u2sb/ObsKeyBoard-SB00/成品/装配2.jpg

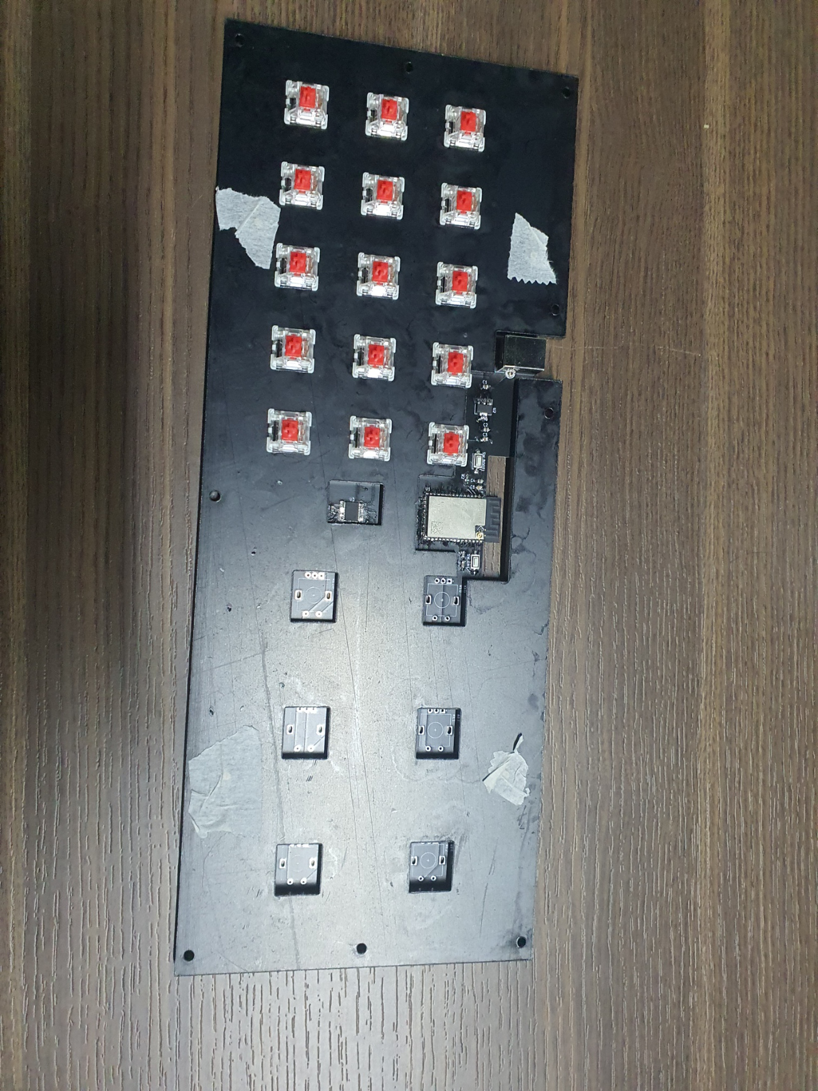
成品/装配2.jpg
