u2sb/ObsKeyBoard-SB00/成品/装配1.jpg

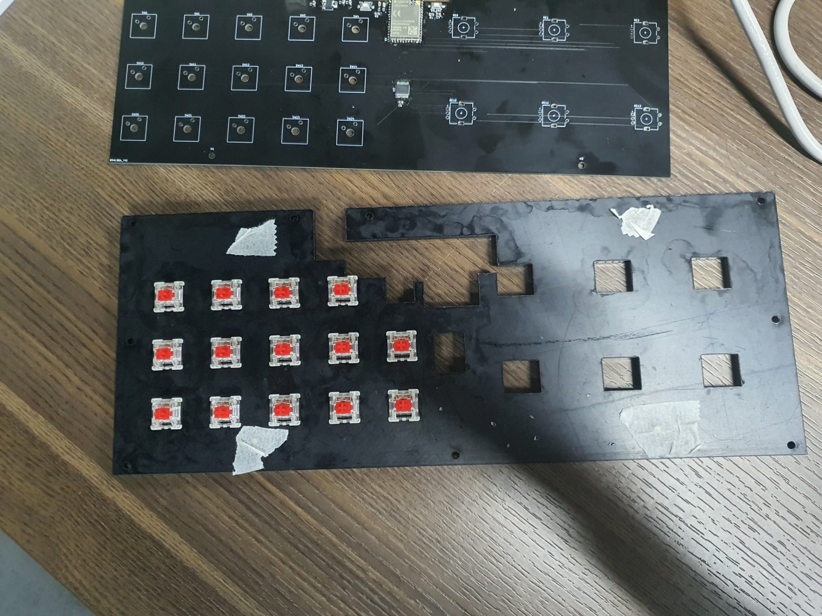
成品/装配1.jpg
