u2sb/ObsKeyBoard-SB00/README.md

OBS 专业导播键盘，包括硬件 + 软件，适合个人 DIY，价格便宜 500 以内即可搞定。
