u2sb/ObsKeyBoard-SB00/固件/README.md

OBS 导播键盘固件，ESP32-S2-WROVER

第三方库：

- [BC_key_scan](https://bitcode.com.cn/product/bc6561/)
- [ESPRotary](https://github.com/LennartHennigs/ESPRotary/)
- [EspSoftwareSerial](https://github.com/plerup/espsoftwareserial/)
