u2sb/ObsKeyBoard-SB00/PCB/README.md

使用 [kicad 6.0](https://www.kicad.org/) 打开

需安装第三方库 [SbKicadLib](https://github.com/u2sb/SbKicadLib)，可直接添加插件 `https://raw.githubusercontent.com/u2sb/SbKicadLib/repository/repository.json`，然后引用路径。
