u2sb/ObsKeyBoard-SB00/外壳/README.md

亚克力板堆叠，比例 1:1，厚度图纸内有标注。

装配表：

| 配件 | 描述 | 数量 |
| :--- | :--- | :--- |
| 铜柱 | M2\*8 滚花，外径 3.2mm | 13 |
| 螺丝 | M2\*6 或 M2\*5 | 26 |
