u2sb/ObsKeyBoard-SB00/成品/PCB.jpg

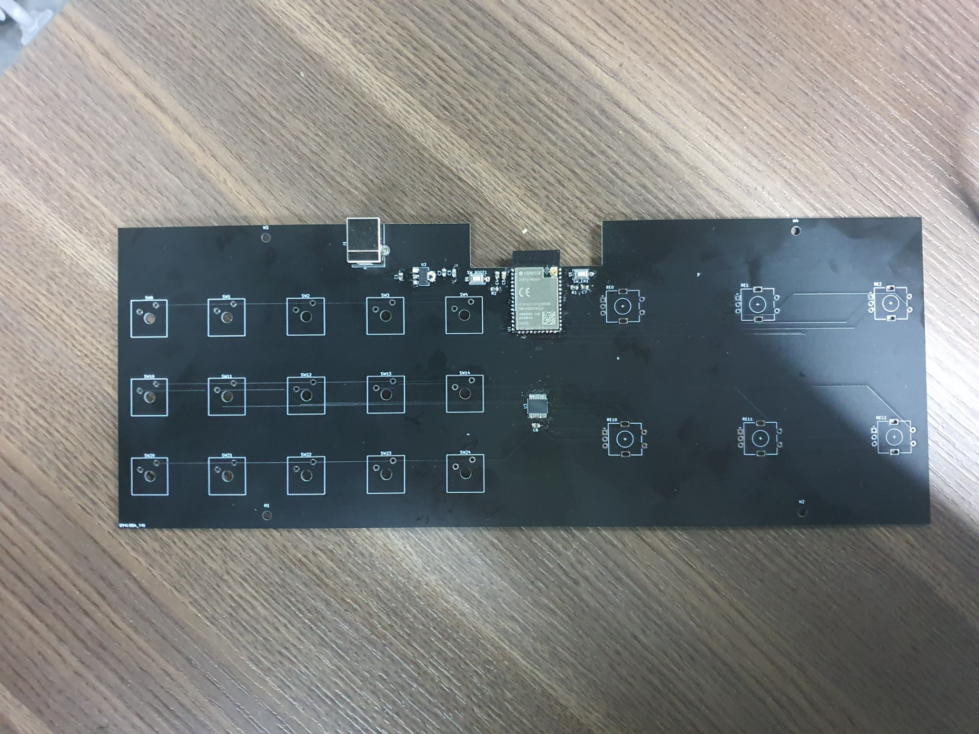
成品/PCB.jpg
