u2sb/ObsKeyBoard-SB00/成品/成品.jpg

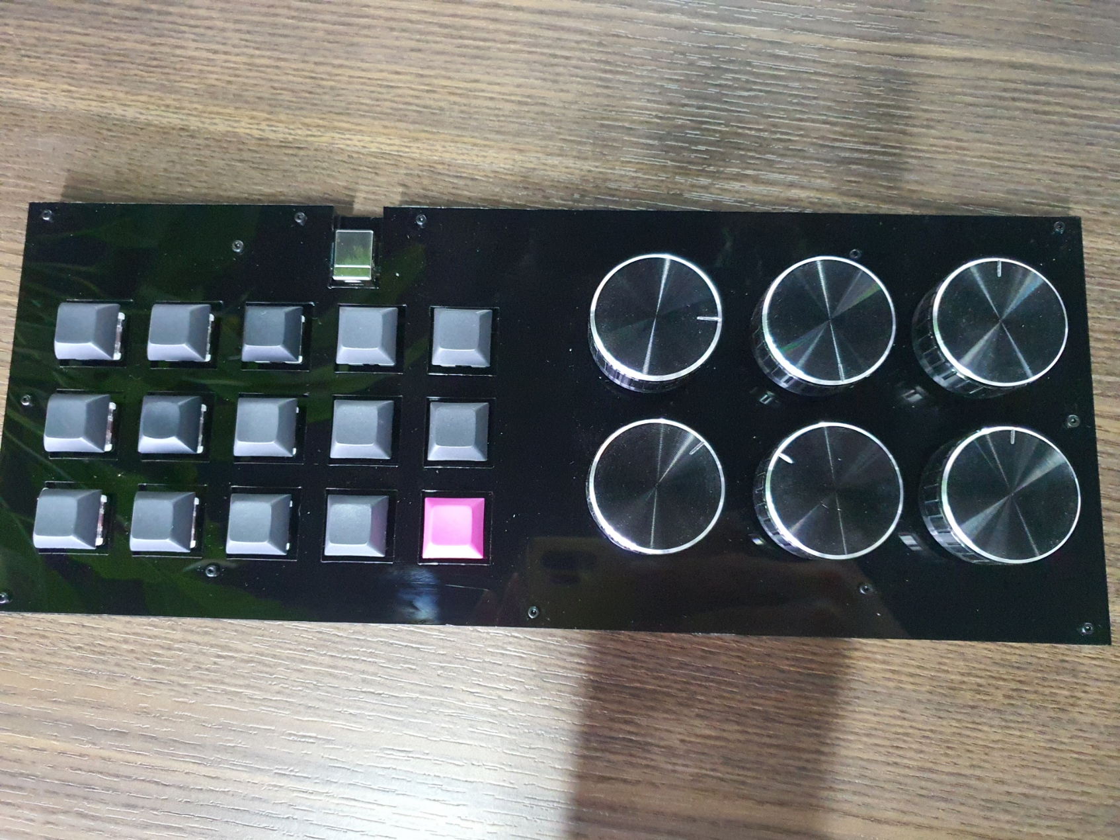
成品/成品.jpg
