u2sb/ObsKeyBoard-SB00/成品/编码器焊接细节.jpg

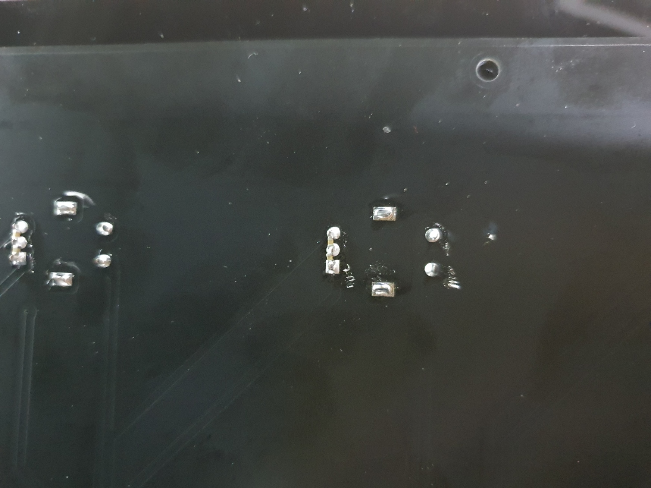
成品/编码器焊接细节.jpg
