u2sb/ObsKeyBoard-SB00/(list of files, cad)

Other CAD files:
外壳/键盘外壳.dwg
