u2sb/ObsKeyBoard-SB00/PCB/ObsKeyBoardHw.kicad_pcb

## KiCad design PCB/ObsKeyBoardHw.kicad_pcb (2022-05-09)

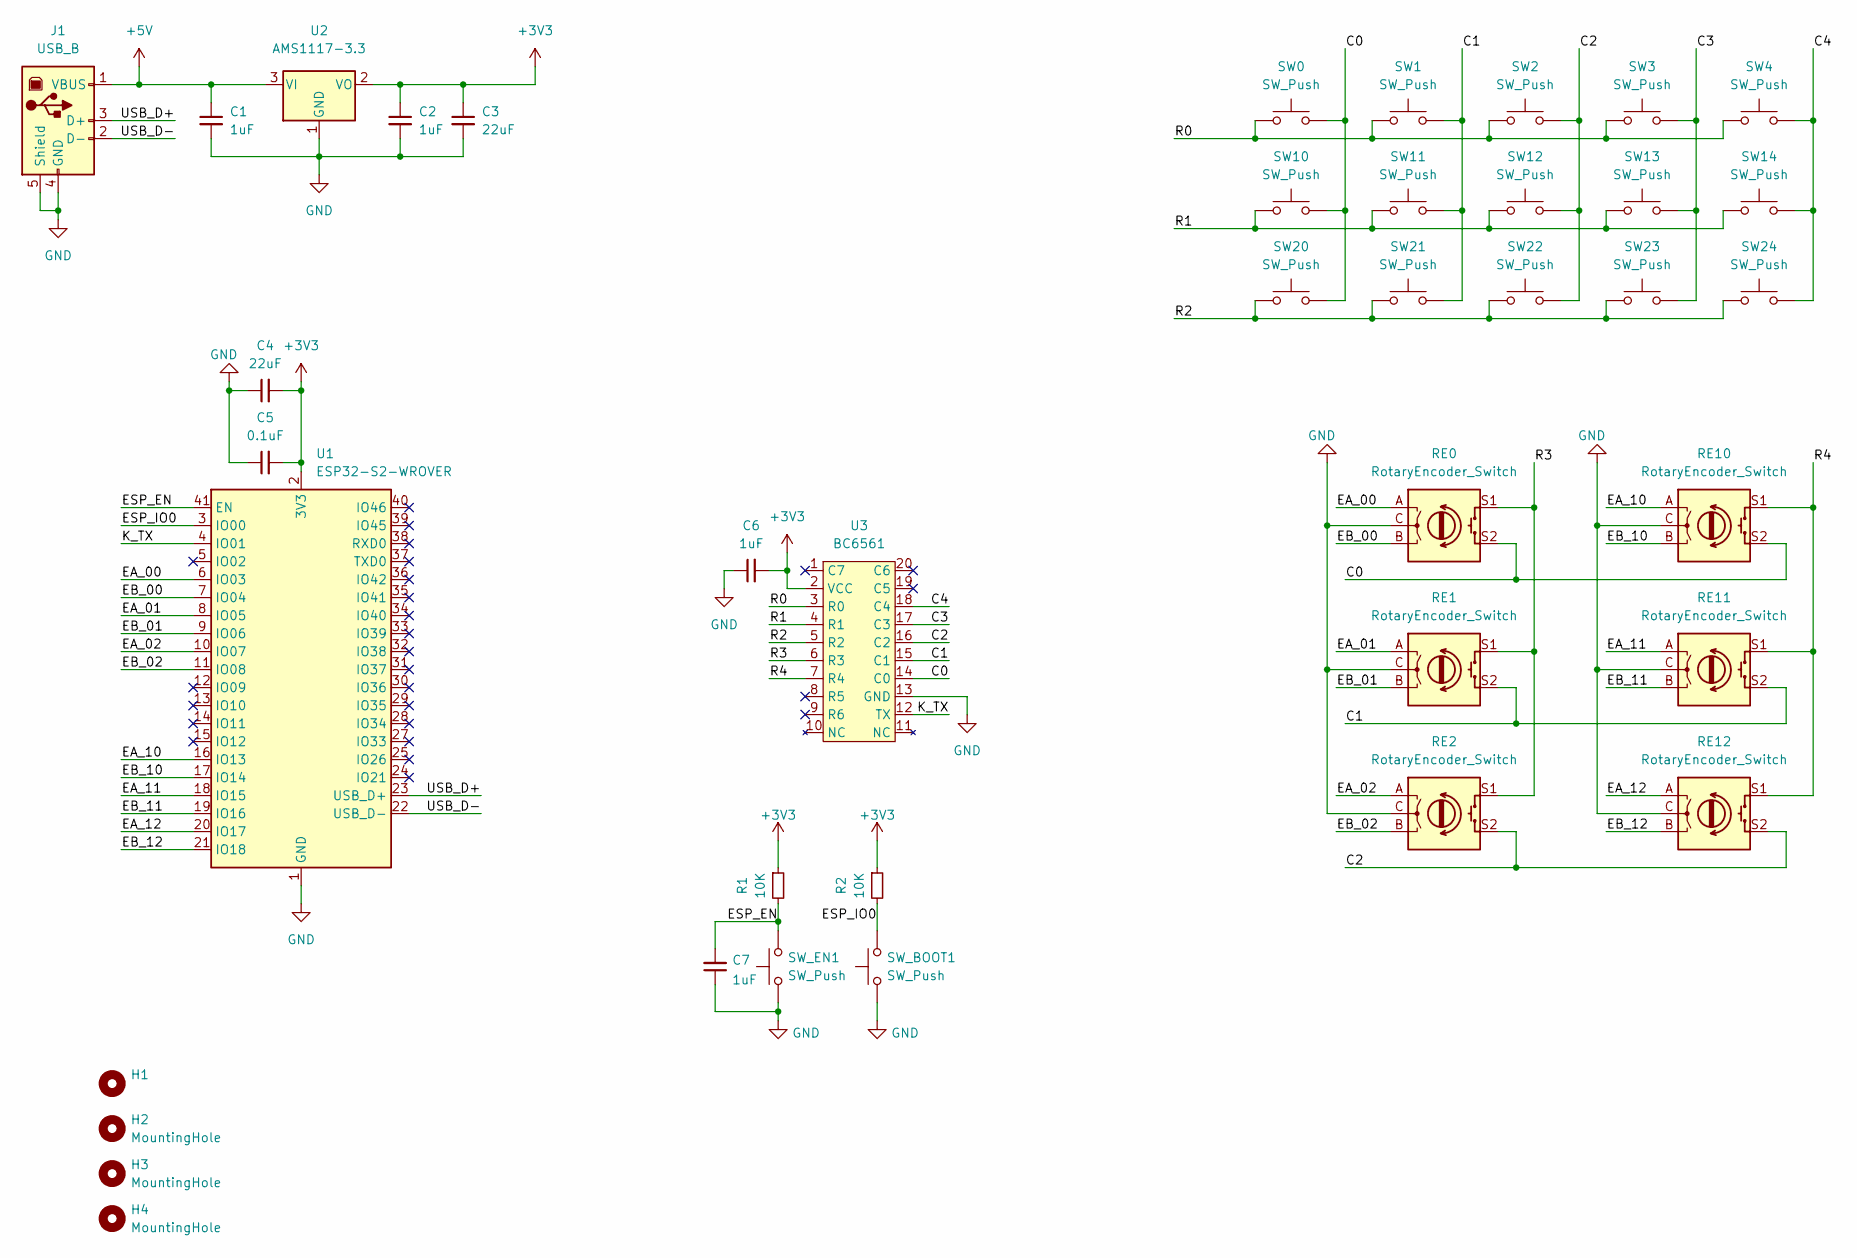
[picture p6: schematic ObsKeyBoardHw.kicad_sch, OBS导播键盘]

Parts:
C1, C2, C6, C7: 1uF; C_0805_2012Metric
C3, C4: 22uF; C_0805_2012Metric
C5: 0.1uF; C_0805_2012Metric
H1: (no value)
H2, H3, H4: MountingHole; MountingHole_3.2mm_M3_ISO7380
J1: USB_B; USB_B_Lumberg_2411_02_Horizontal
R1, R2: 10K; R_0805_2012Metric
RE0, RE1, RE2, RE10, RE11, RE12: RotaryEncoder_Switch; RotaryEncoder_Alps_EC11E-Switch_Vertical_H20mm
SW0, SW1, SW2, SW3, SW4, SW10, SW11, SW12, SW13, SW14, SW20, SW21, SW22, SW23, SW24: SW_Push; SW_Cherry_MX_1.00u_Plate
SW_BOOT1: SW_Push; SW_SPST_CK_RS282G05A3
SW_EN1: SW_Push; SW_SPST_CK_RS282G05A3
U1: ESP32-S2-WROVER
U2: AMS1117-3.3; SOT-223-3_TabPin2
U3: BC6561; SSOP-20_5.3x7.2mm_P0.65mm

Connections:
+3V3: C2.1, C3.1, C4.2, C5.2, C6.2, R1.1, R2.1, U1.2 (3V3), U2.2 (VO), U3.2 (VCC)
+5V: C1.1, J1.1 (VBUS), U2.3 (VI)
/C0: RE0.S2, RE10.S2, SW0.2, SW10.2, SW20.2, U3.14 (C0)
/C1: RE1.S2, RE11.S2, SW1.2, SW11.2, SW21.2, U3.15 (C1)
/C2: RE2.S2, RE12.S2, SW2.2, SW12.2, SW22.2, U3.16 (C2)
/C3: SW3.2, SW13.2, SW23.2, U3.17 (C3)
/C4: SW4.2, SW14.2, SW24.2, U3.18 (C4)
/EA_00: RE0.A, U1.6 (IO03)
/EA_01: RE1.A, U1.8 (IO05)
/EA_02: RE2.A, U1.10 (IO07)
/EA_10: RE10.A, U1.16 (IO13)
/EA_11: RE11.A, U1.18 (IO15)
/EA_12: RE12.A, U1.20 (IO17)
/EB_00: RE0.B, U1.7 (IO04)
/EB_01: RE1.B, U1.9 (IO06)
/EB_02: RE2.B, U1.11 (IO08)
/EB_10: RE10.B, U1.17 (IO14)
/EB_11: RE11.B, U1.19 (IO16)
/EB_12: RE12.B, U1.21 (IO18)
/ESP_EN: C7.2, R1.2, SW_EN1.2, U1.41 (EN)
/ESP_IO0: R2.2, SW_BOOT1.2, U1.3 (IO00)
/K_TX: U1.4 (IO01), U3.12 (TX)
/R0: SW0.1, SW1.1, SW2.1, SW3.1, SW4.1, U3.3 (R0)
/R1: SW10.1, SW11.1, SW12.1, SW13.1, SW14.1, U3.4 (R1)
/R2: SW20.1, SW21.1, SW22.1, SW23.1, SW24.1, U3.5 (R2)
/R3: RE0.S1, RE1.S1, RE2.S1, U3.6 (R3)
/R4: RE10.S1, RE11.S1, RE12.S1, U3.7 (R4)
/USB_D+: J1.3 (D+), U1.23 (USB_D+)
/USB_D-: J1.2 (D-), U1.22 (USB_D-)
GND: C1.2, C2.2, C3.2, C4.1, C5.1, C6.1, C7.1, J1.4 (GND), J1.5 (Shield), RE0.C, RE1.C, RE2.C, RE10.C, RE11.C, RE12.C, SW_BOOT1.1, SW_EN1.1, U1.1 (GND), U1.26 (GND), U1.42 (GND), U1.43 (GND), U2.1 (GND), U3.13 (GND)

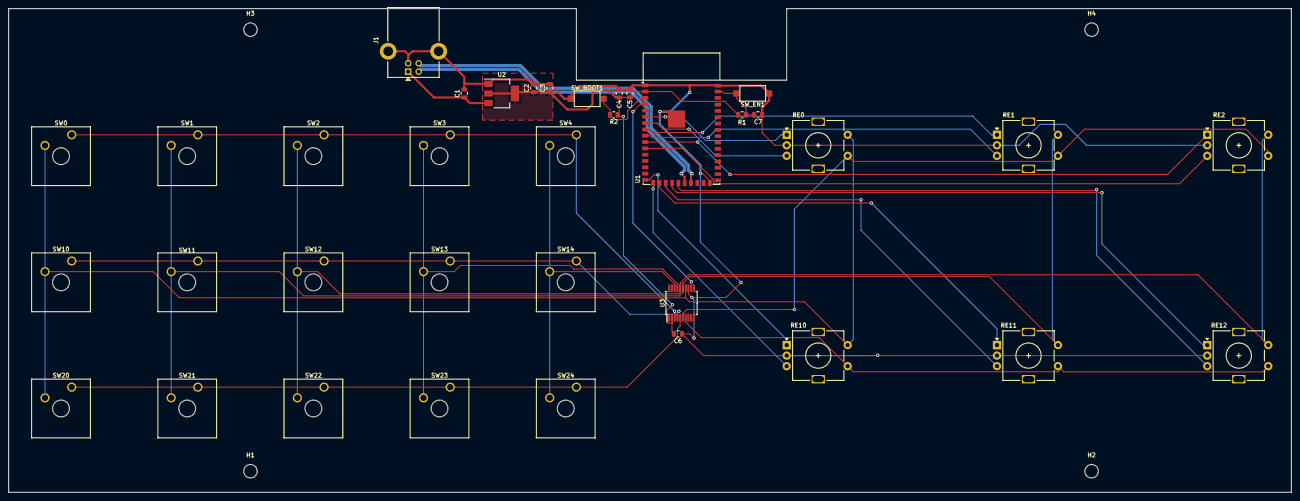
[picture p7: board ObsKeyBoardHw.kicad_pcb from above]

Board: 2 copper layers, 305.0 x 115.0 mm, 40 parts (0 on the bottom side), 30 nets.
