u2sb/ObsKeyBoard-SB00/(commit log)

2022-05-06 初始版本
    [ObsKeyBoardHw.kicad_pcb, ObsKeyBoardHw.kicad_sch]
2022-05-09 添加外壳
    [ObsKeyBoardHw.kicad_pcb, ObsKeyBoardHw.kicad_sch, 键盘外壳.dwg]
2022-05-09 更新标题
    [ObsKeyBoardHw.kicad_pcb]
2022-05-10 更新固件
2022-05-11 更新程序
2022-05-12 更新目录结构
    [ObsKeyBoardHw.kicad_pcb, ObsKeyBoardHw.kicad_sch, 键盘外壳.dwg]
2022-05-12 更新固件介绍
2022-10-17 支持OBS28
2022-10-29 更新固件和上位机
2022-10-29 更新上位机
2022-10-31 更新上位机算法
2022-10-31 增加数据校验机制
